aukhalid/evpix_rv32/images/area_comp.png

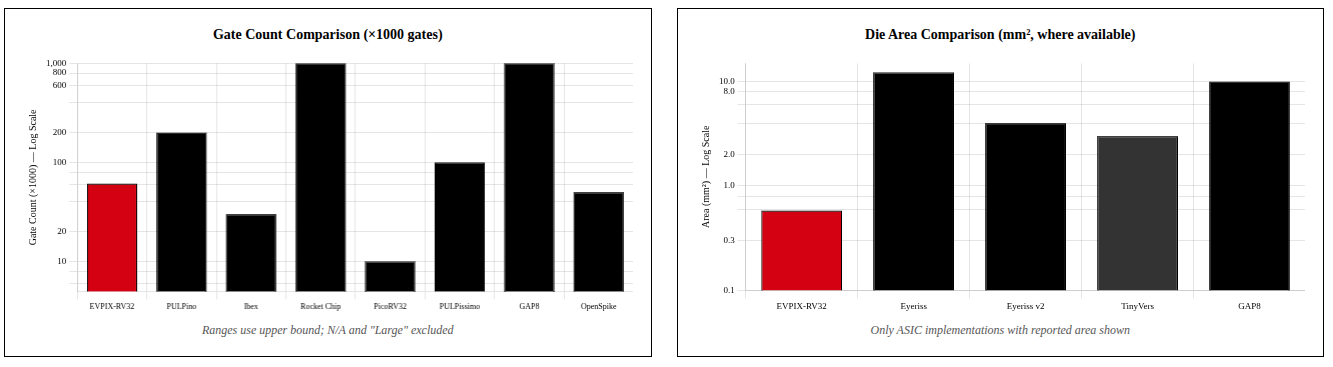
images/area_comp.png
