aukhalid/evpix_rv32/images/asic_heat_map_2_new.png

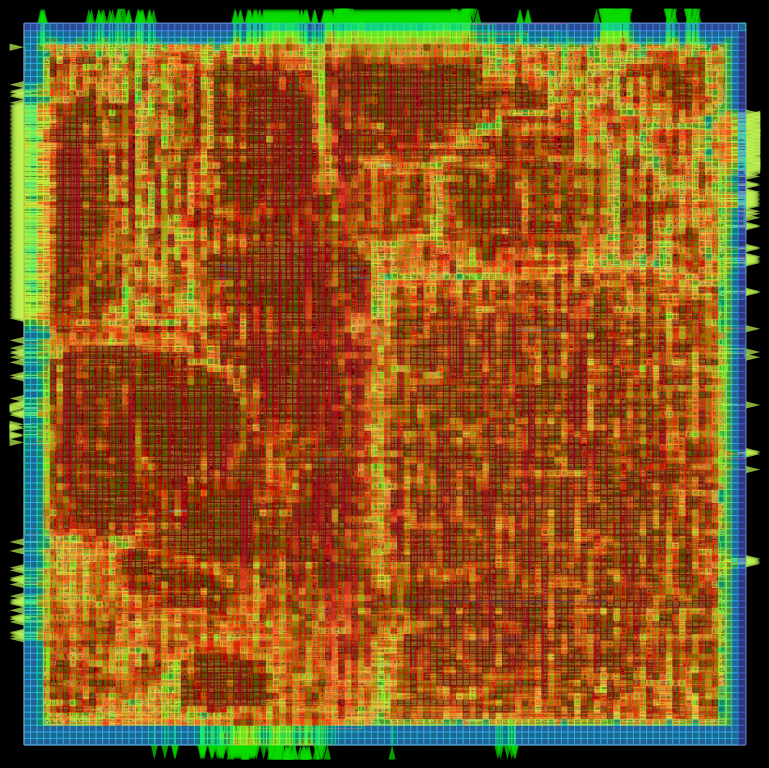
images/asic_heat_map_2_new.png
