aukhalid/evpix_rv32/images/asic_heat_map_new.png

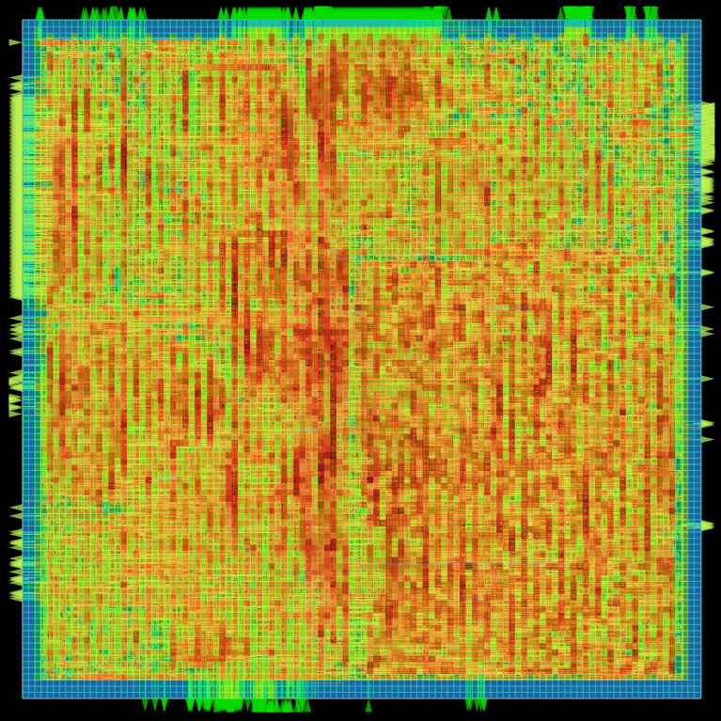
images/asic_heat_map_new.png
