aukhalid/evpix_rv32/images/Basys-3pmod.png

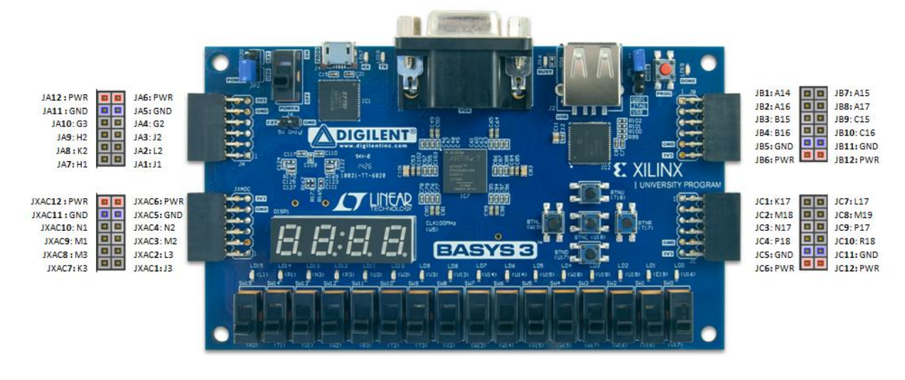
images/Basys-3pmod.png
