aukhalid/evpix_rv32/images/closeup_detailed_asic.png

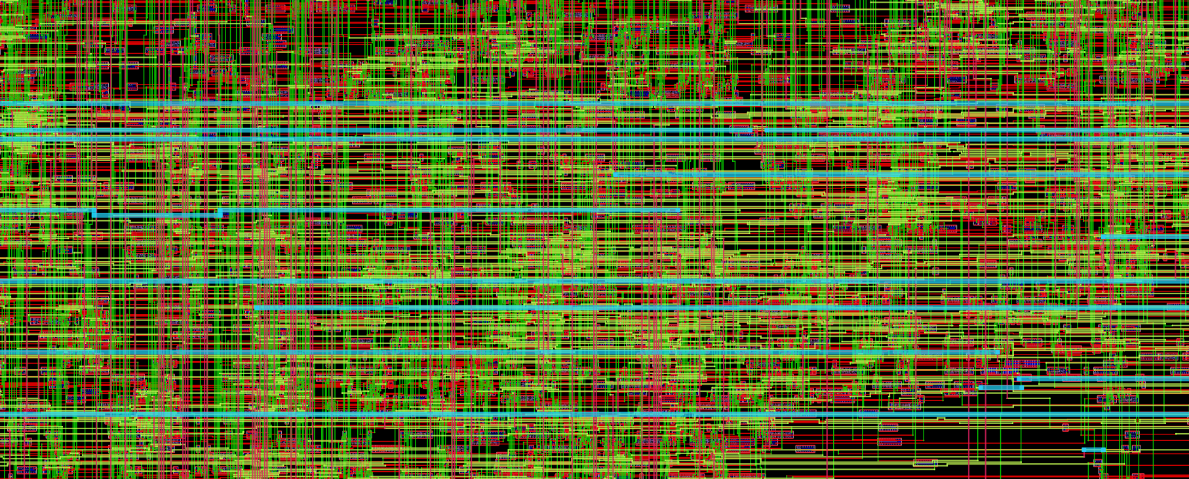
images/closeup_detailed_asic.png
