aukhalid/evpix_rv32/images/custom_ins.png

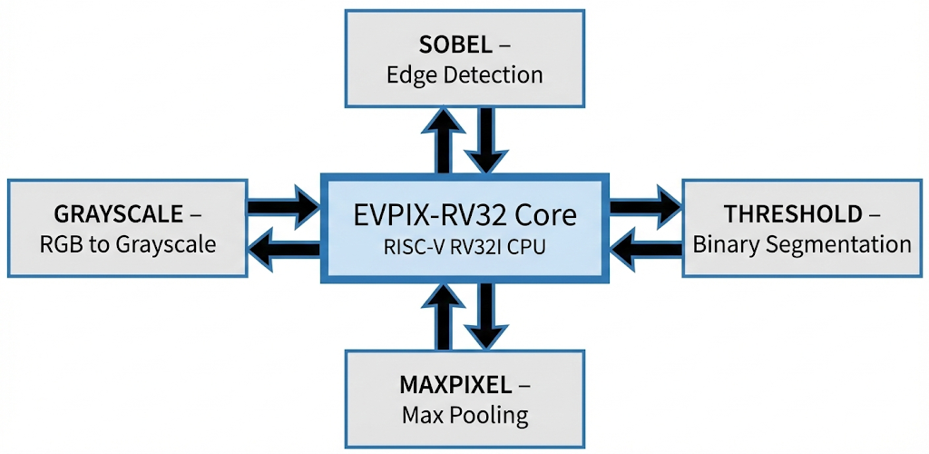
images/custom_ins.png
