aukhalid/evpix_rv32/images/detailed_transistor_layout_alu.png

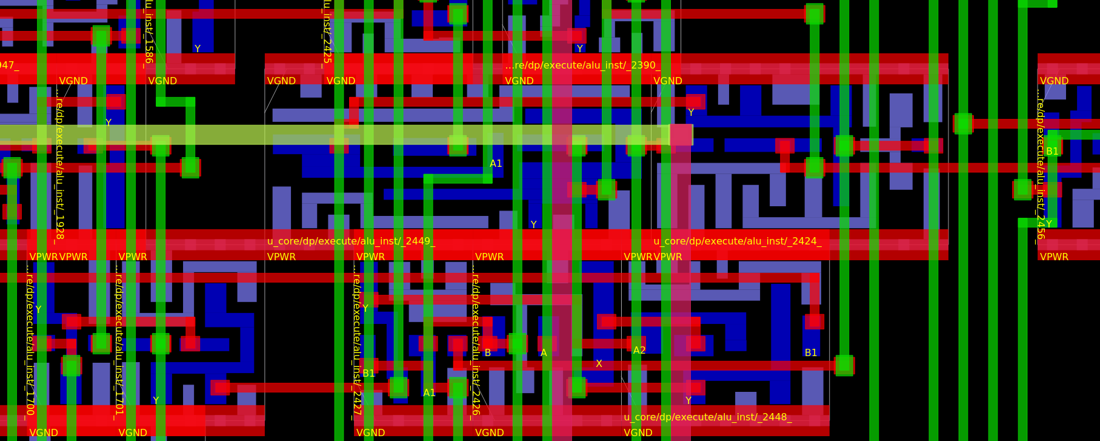
images/detailed_transistor_layout_alu.png
