aukhalid/evpix_rv32/images/evpix_comparison_features2.png

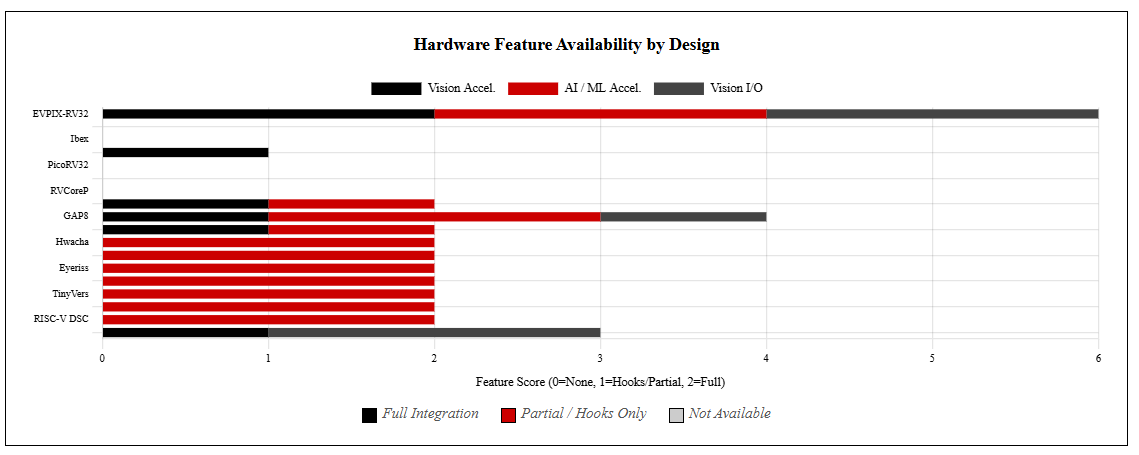
images/evpix_comparison_features2.png
