aukhalid/evpix_rv32/images/evpix_comparison_final_position2.png

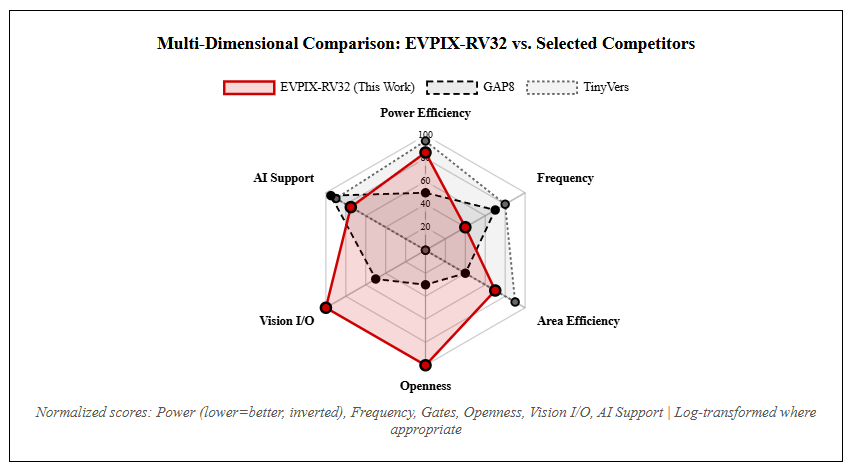
images/evpix_comparison_final_position2.png
