aukhalid/evpix_rv32/images/evpix_comparison_final_position.png

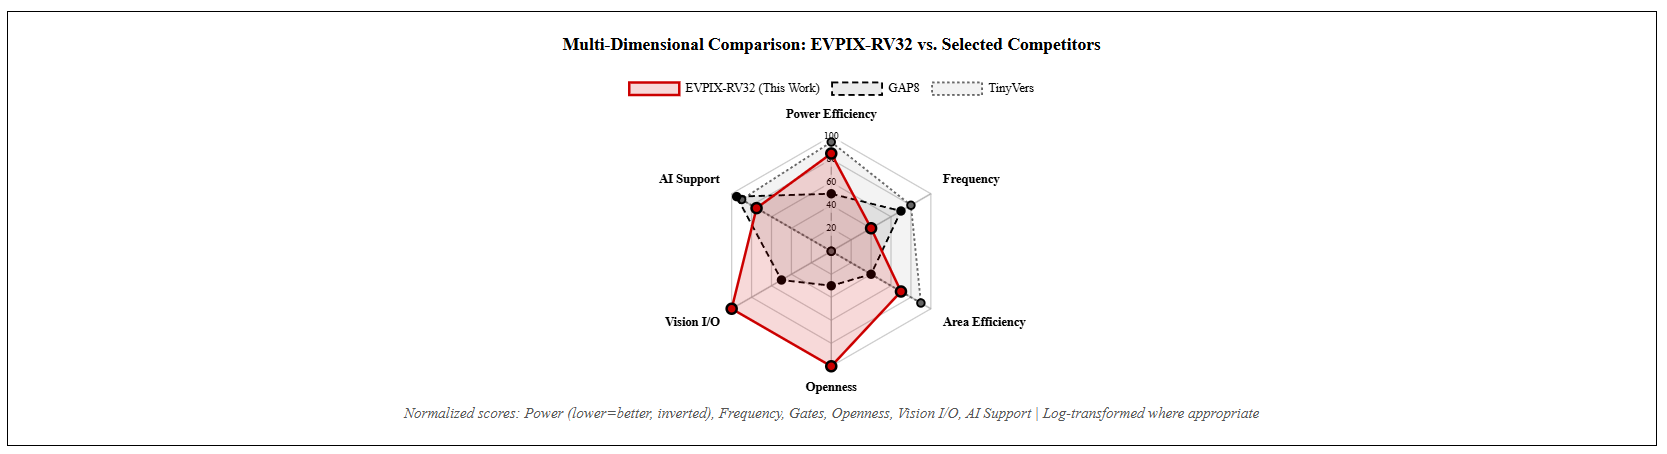
images/evpix_comparison_final_position.png
