aukhalid/evpix_rv32/images/evpix_comparison_open_source.png

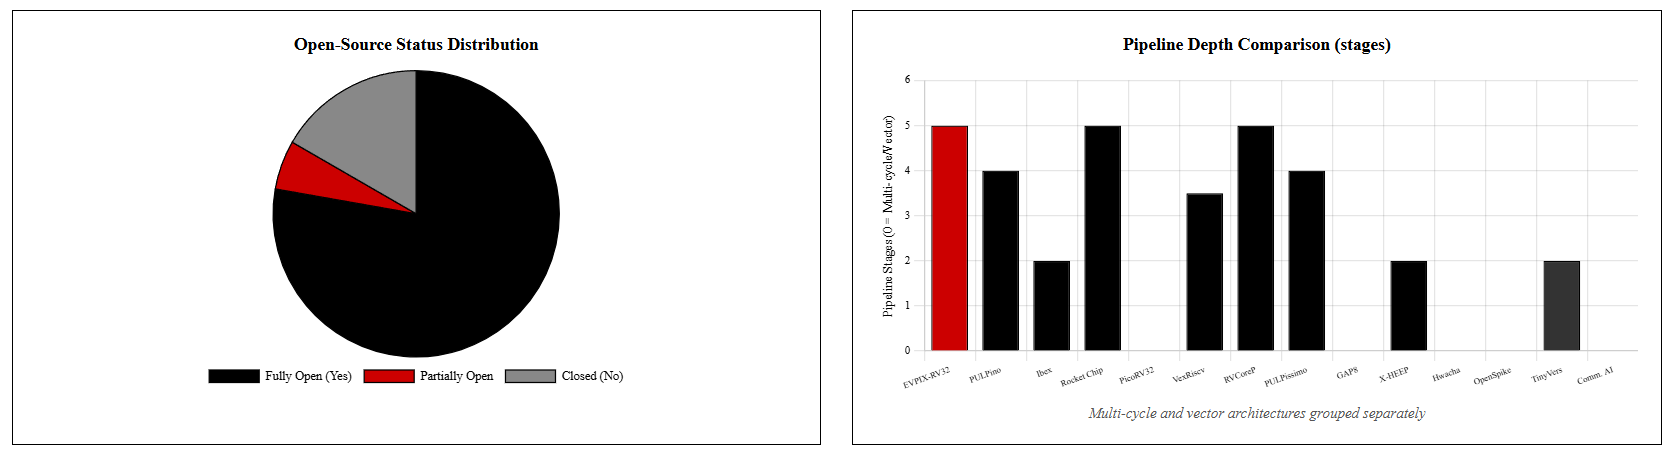
images/evpix_comparison_open_source.png
