aukhalid/evpix_rv32/images/evpix_comparison_power2.png

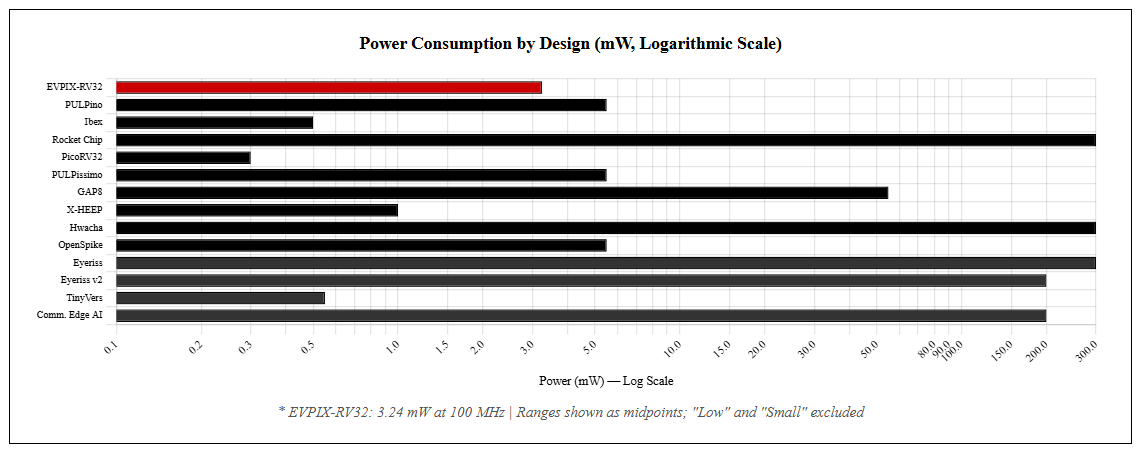
images/evpix_comparison_power2.png
