aukhalid/evpix_rv32/images/evpix_comparison_power.png

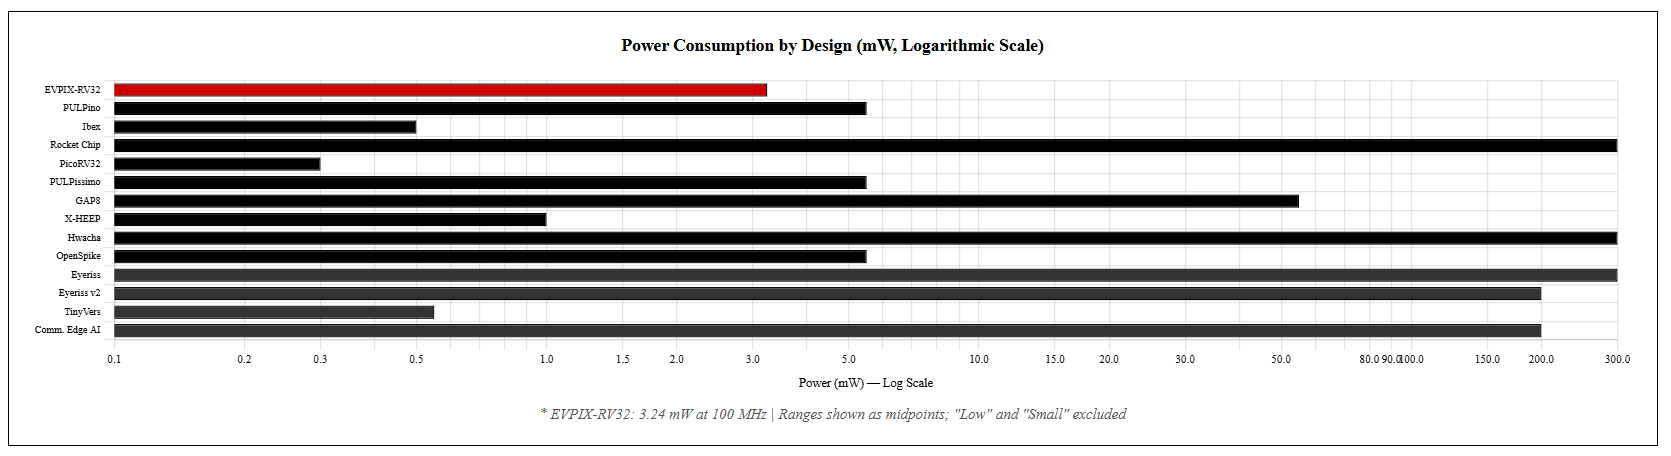
images/evpix_comparison_power.png
