aukhalid/evpix_rv32/images/evpix_comparison_table.png

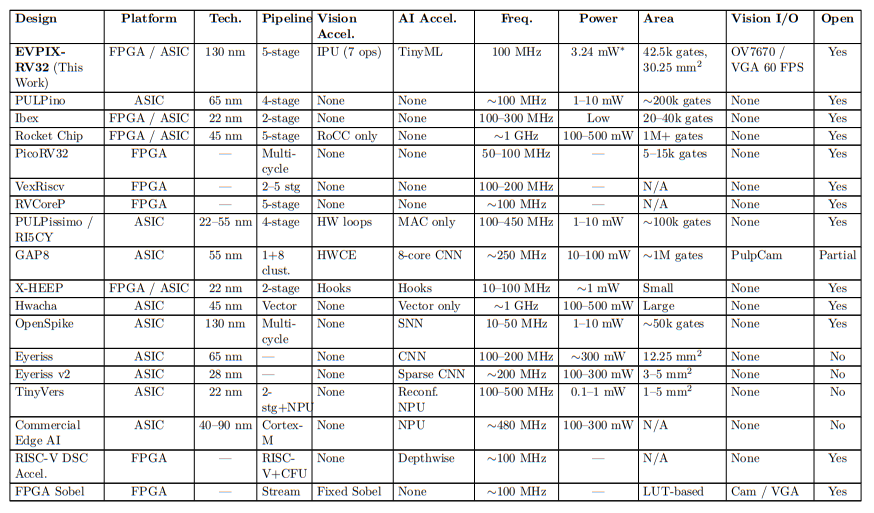
images/evpix_comparison_table.png
