aukhalid/evpix_rv32/images/evpix_comparison_technology.png

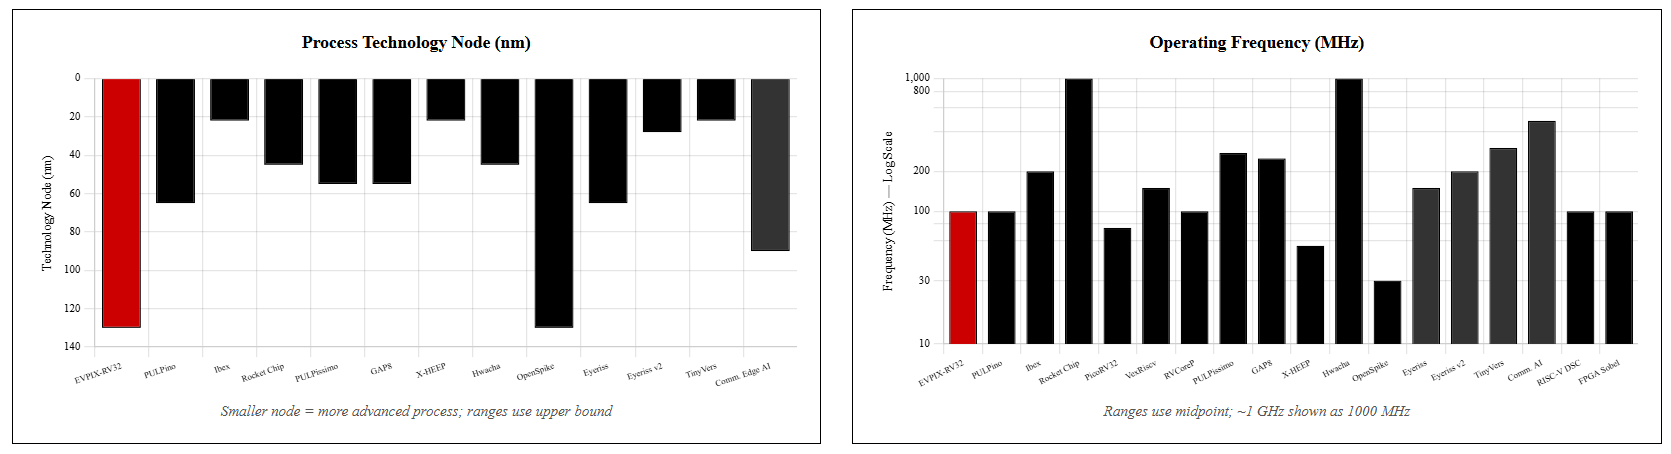
images/evpix_comparison_technology.png
