aukhalid/evpix_rv32/images/feature_comp.png

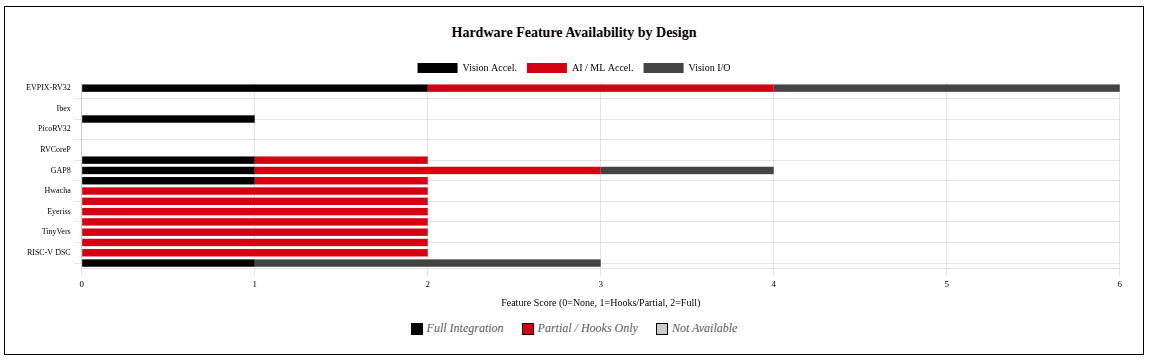
images/feature_comp.png
