aukhalid/evpix_rv32/images/fetch.png

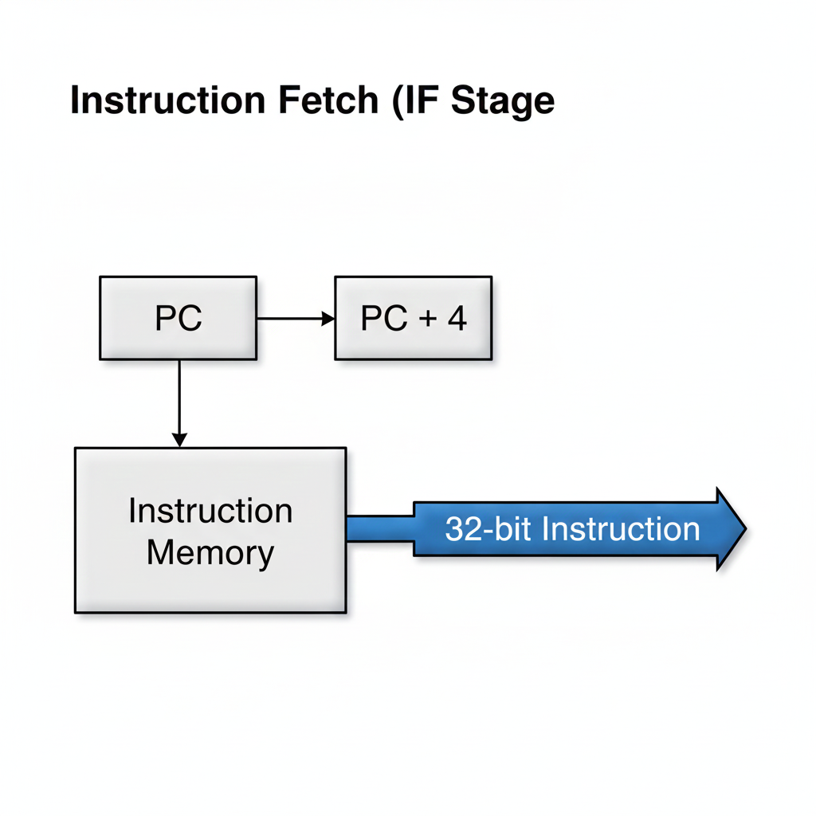
images/fetch.png
