aukhalid/evpix_rv32/images/fpga.png

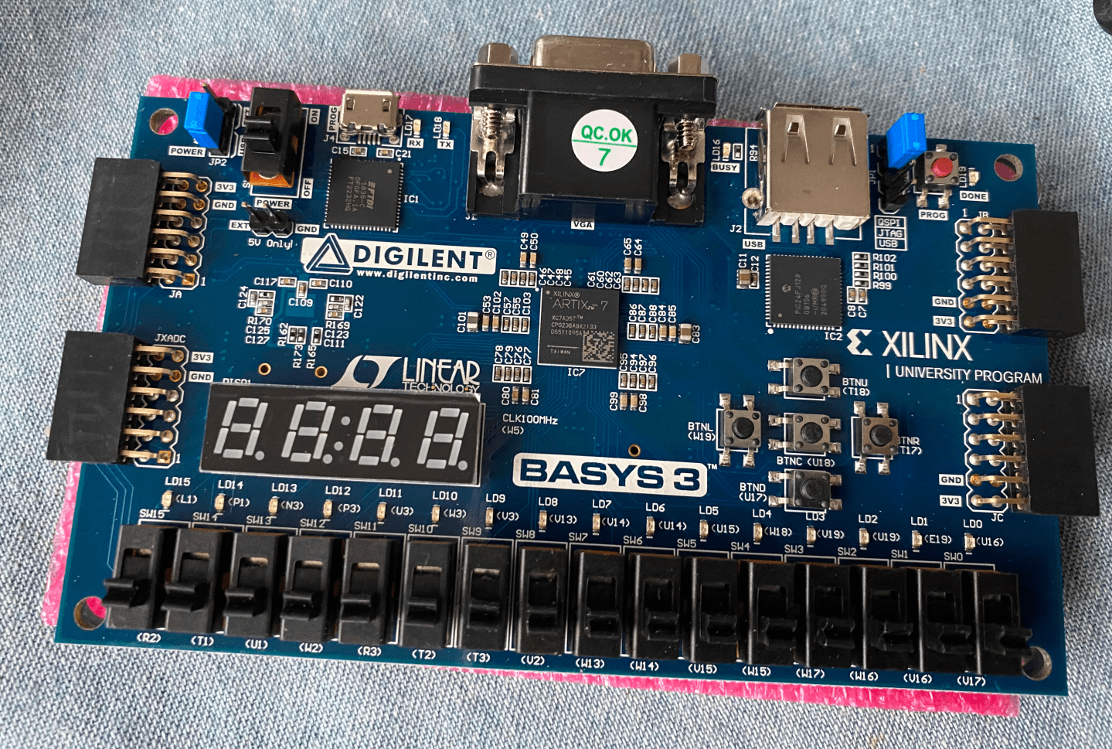
images/fpga.png
