aukhalid/evpix_rv32/images/fpga_power.png

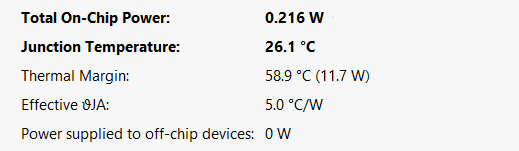
images/fpga_power.png
