aukhalid/evpix_rv32/images/fpga_time.png

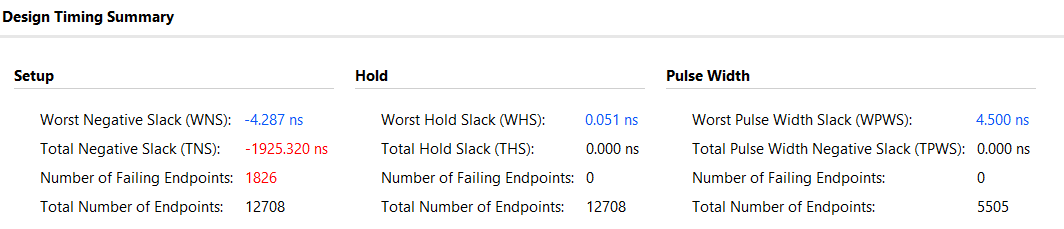
images/fpga_time.png
