aukhalid/evpix_rv32/images/fpga_ut.png

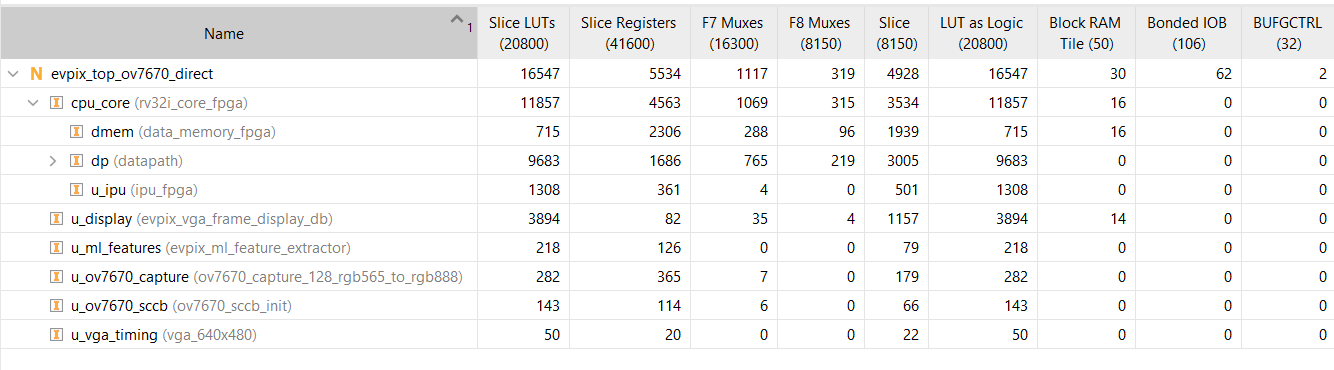
images/fpga_ut.png
