aukhalid/evpix_rv32/images/Harvard-architecture.jpg

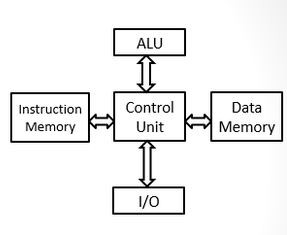
images/Harvard-architecture.jpg
