aukhalid/evpix_rv32/images/hazerd.png

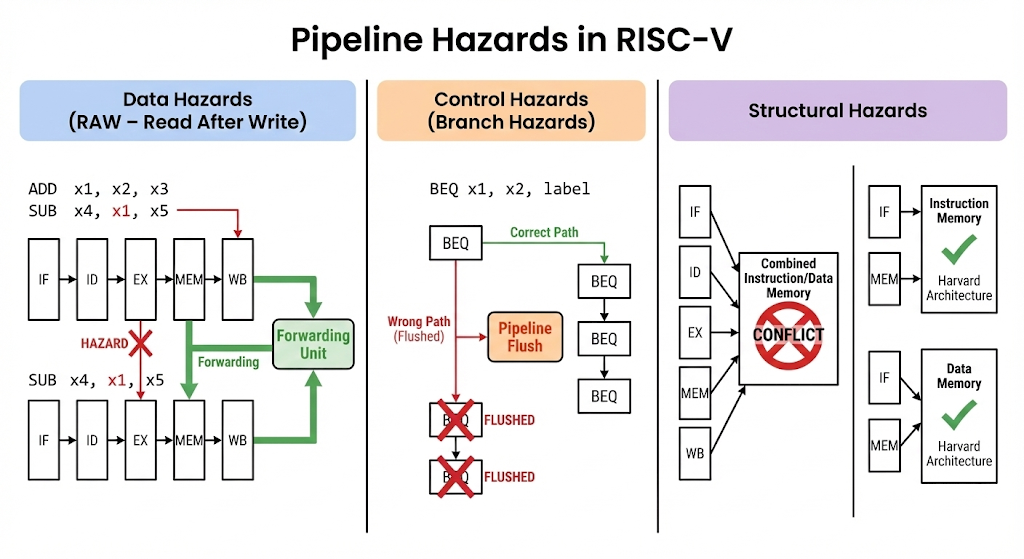
images/hazerd.png
