aukhalid/evpix_rv32/images/io_right.png

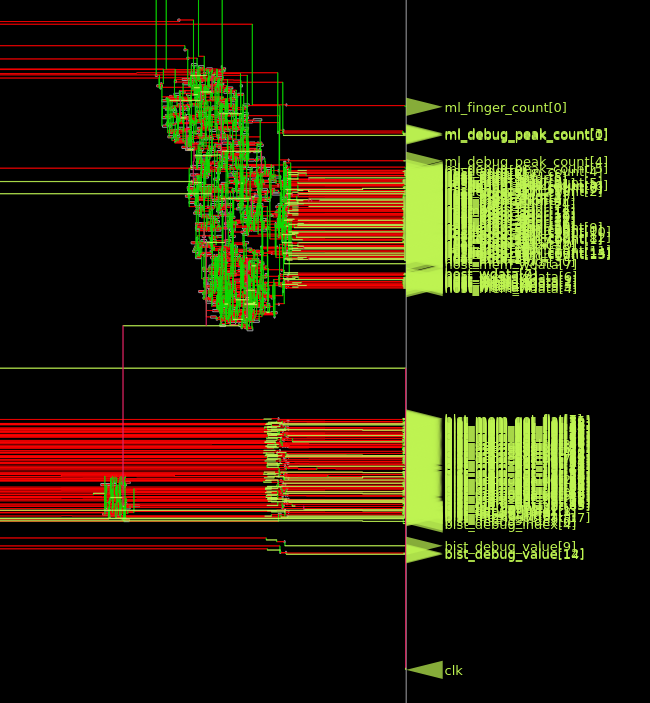
images/io_right.png
