aukhalid/evpix_rv32/images/lut.png

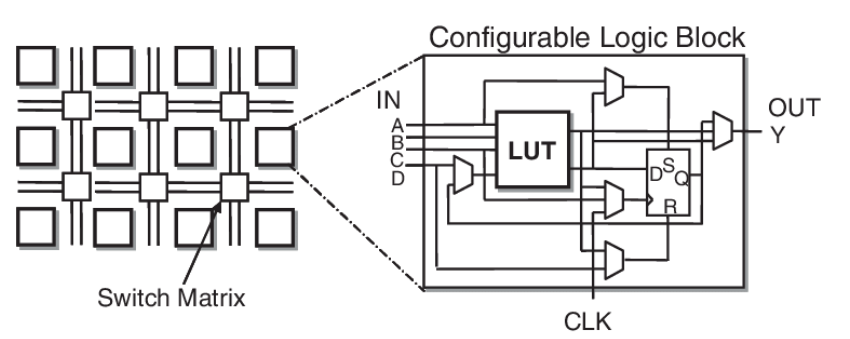
images/lut.png
