aukhalid/evpix_rv32/images/overall_comp.png

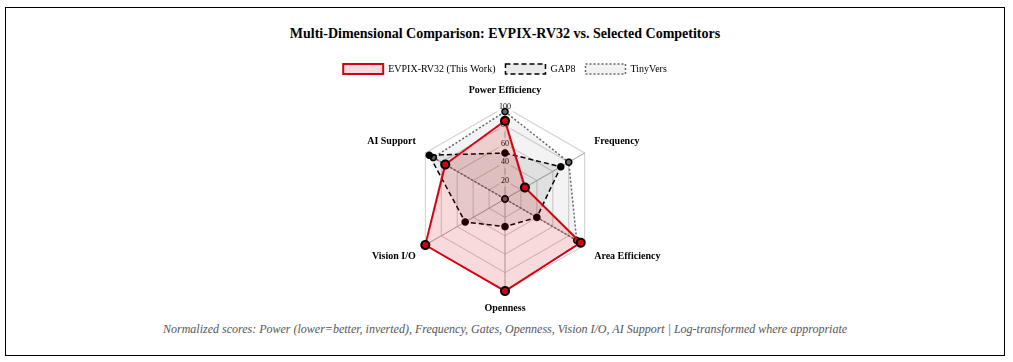
images/overall_comp.png
