aukhalid/evpix_rv32/images/reg_types.png

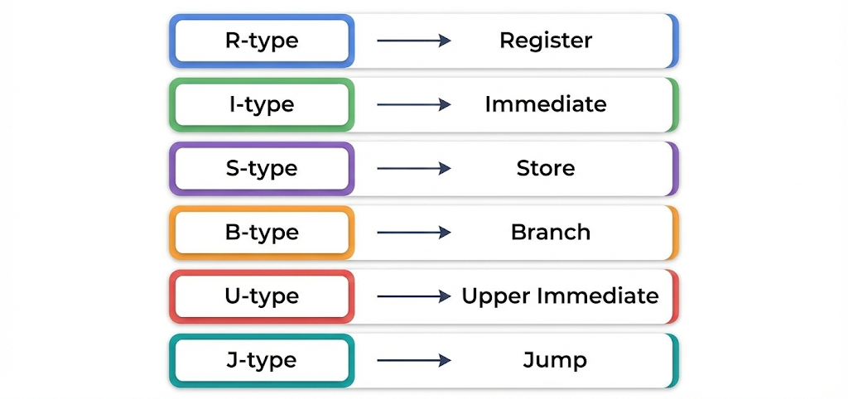
images/reg_types.png
