aukhalid/evpix_rv32/images/soc_top_detailed.png

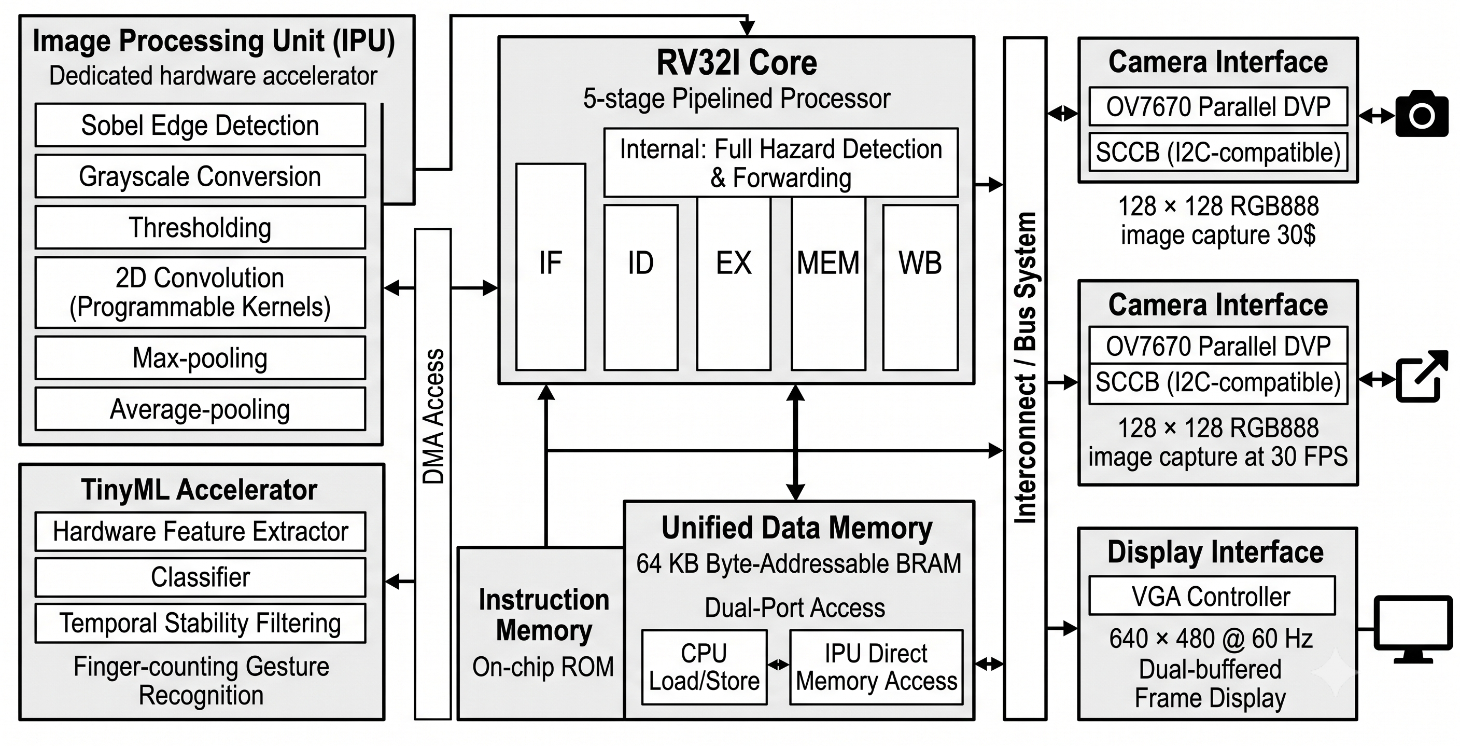
images/soc_top_detailed.png
