aukhalid/evpix_rv32/images/spi_input_13fps.png

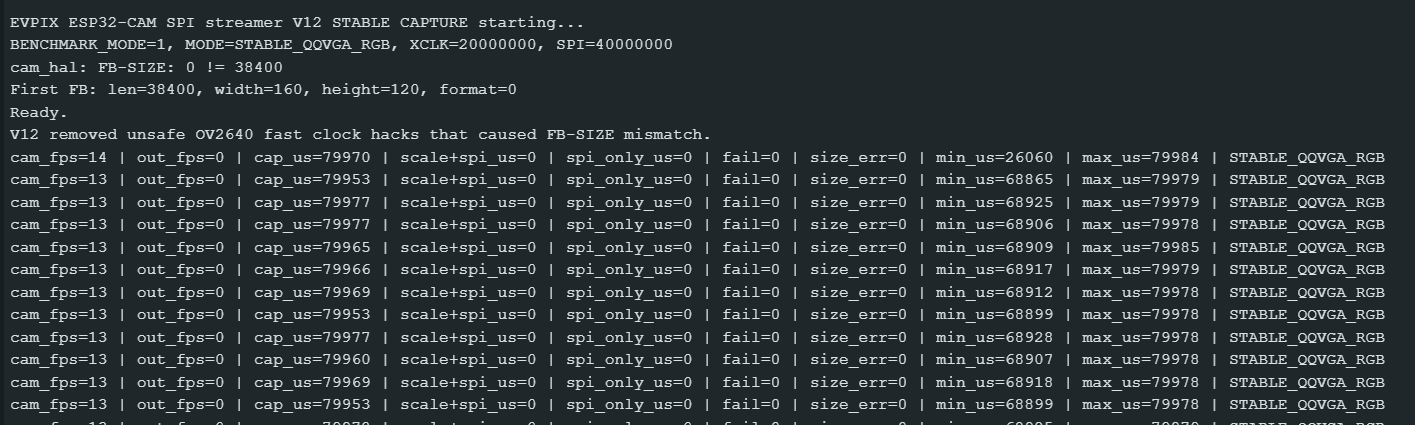
images/spi_input_13fps.png
