aukhalid/evpix_rv32/images/spi_output_133fps.png

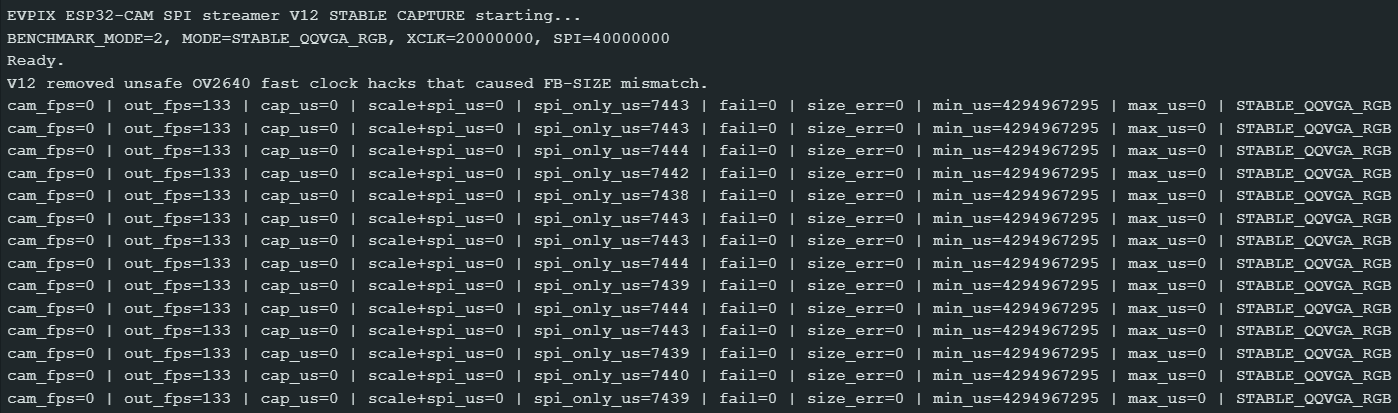
images/spi_output_133fps.png
