aukhalid/evpix_rv32/images/webcam_fps.png

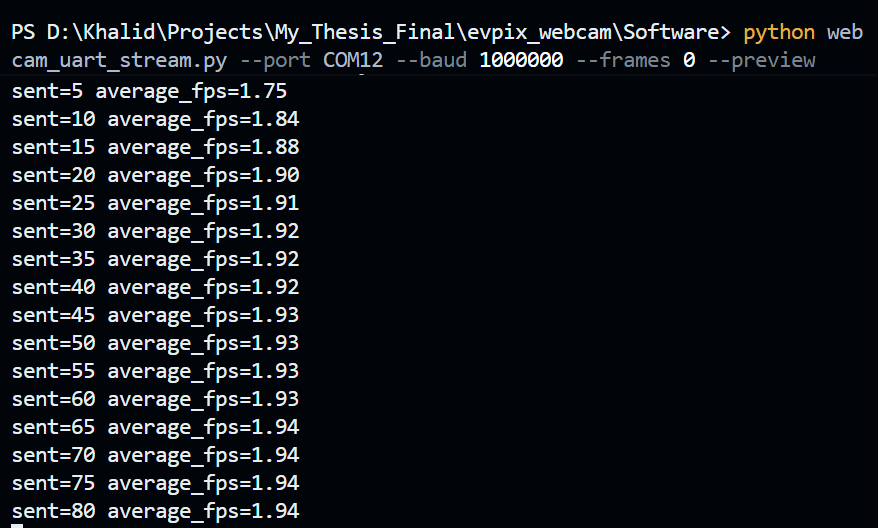
images/webcam_fps.png
