aukhalid/evpix_rv32/images/asic_all_results_summary.png

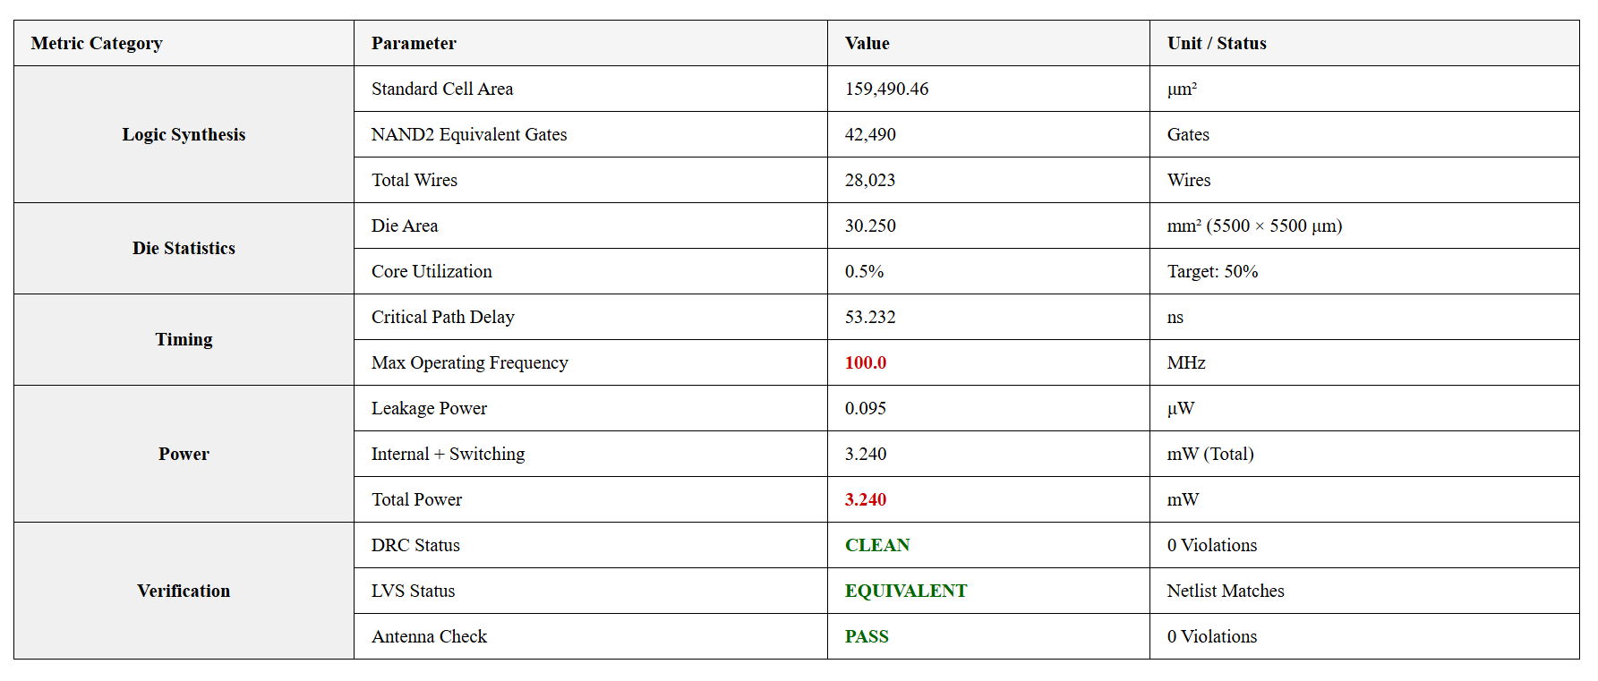
images/asic_all_results_summary.png
