aukhalid/evpix_rv32/images/asic_power_results2.png

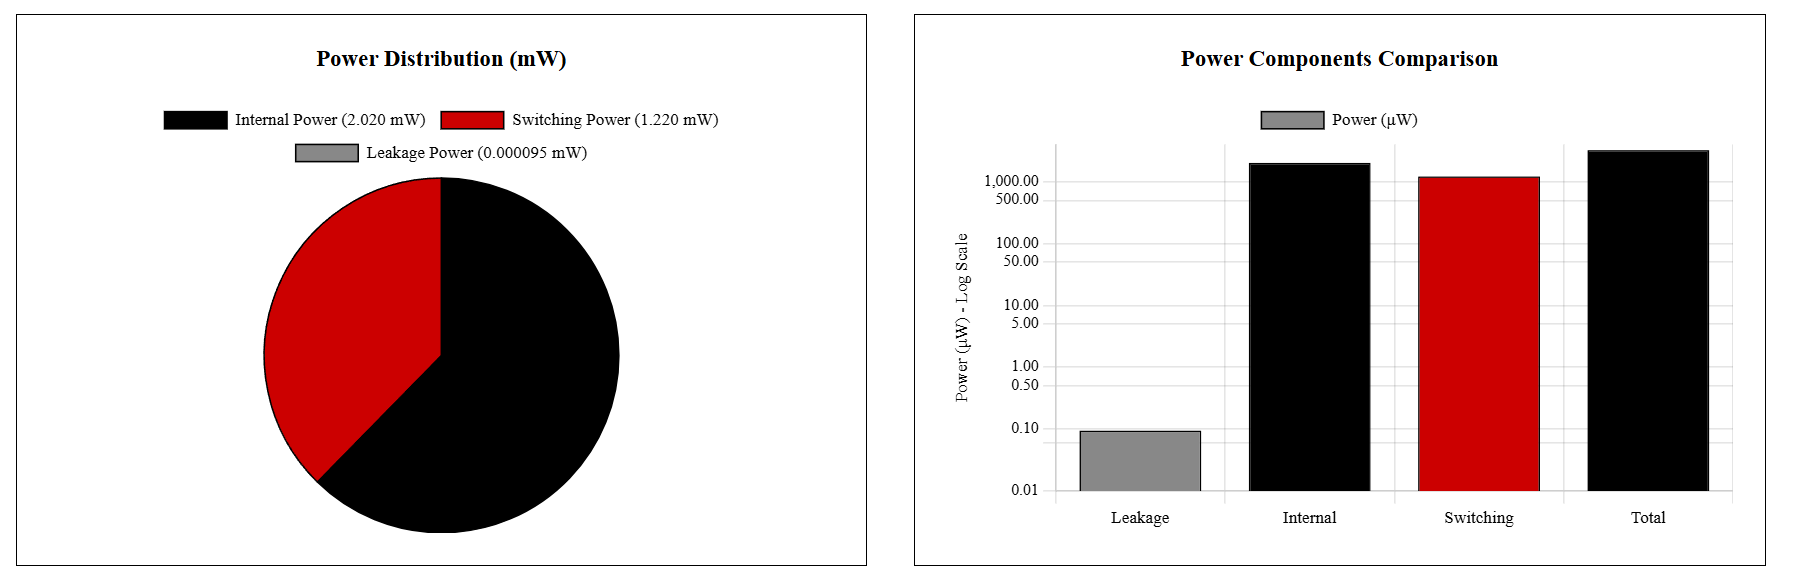
images/asic_power_results2.png
