aukhalid/evpix_rv32/images/asic_power_summary_results.png

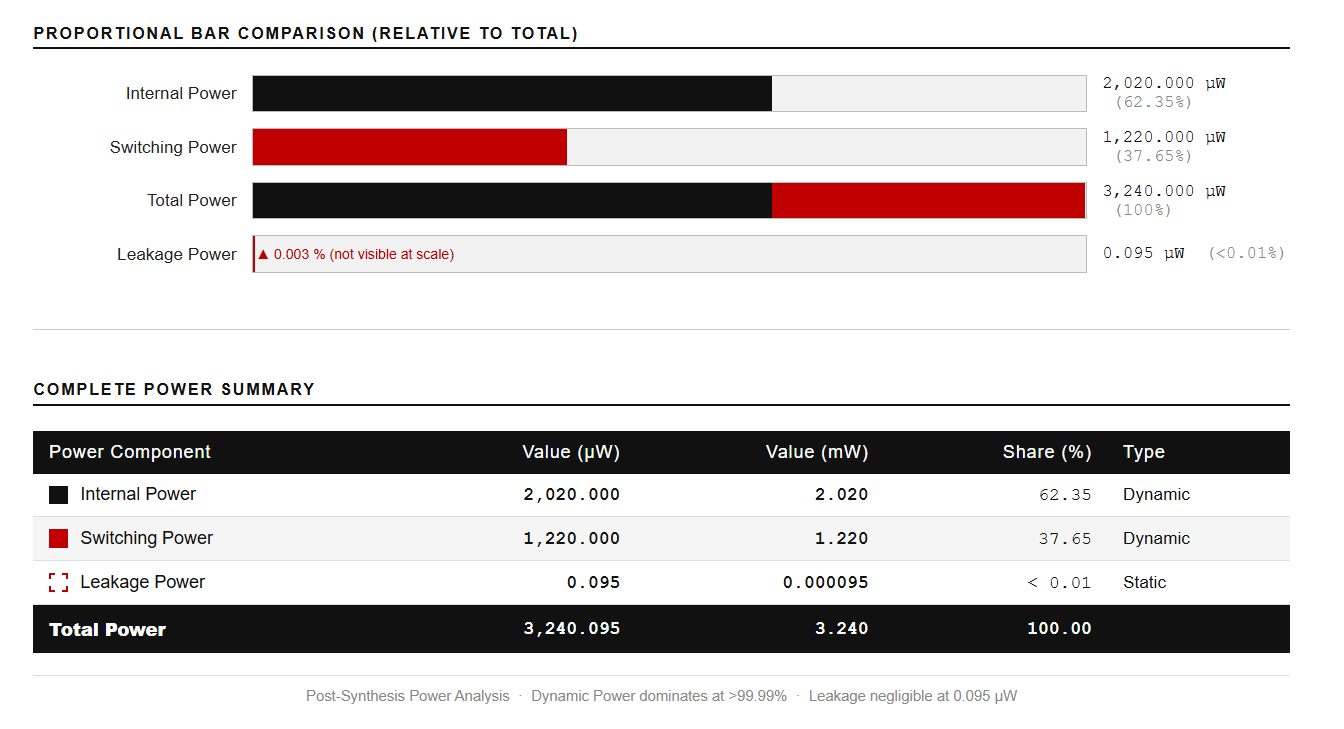
images/asic_power_summary_results.png
