aukhalid/evpix_rv32/images/asic_timing_results2.png

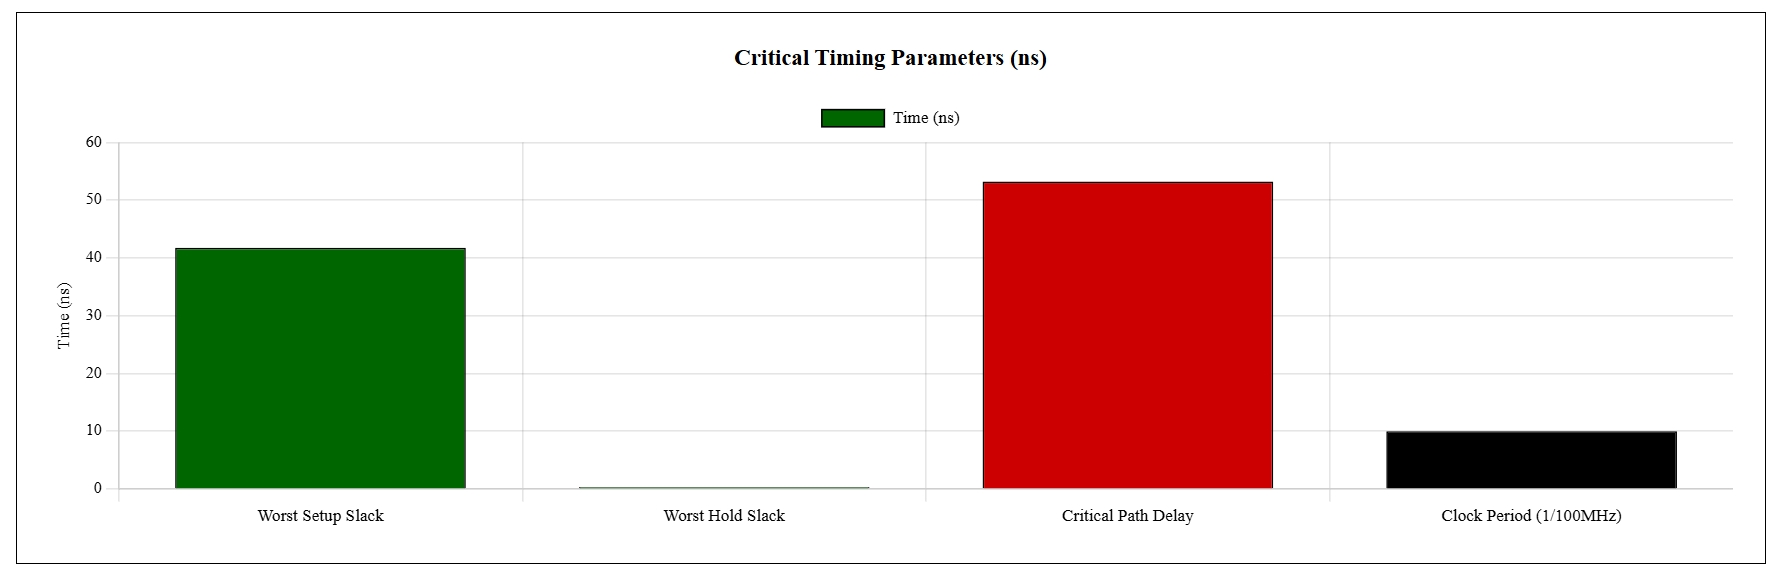
images/asic_timing_results2.png
