aukhalid/evpix_rv32/images/asic_timing_results.png

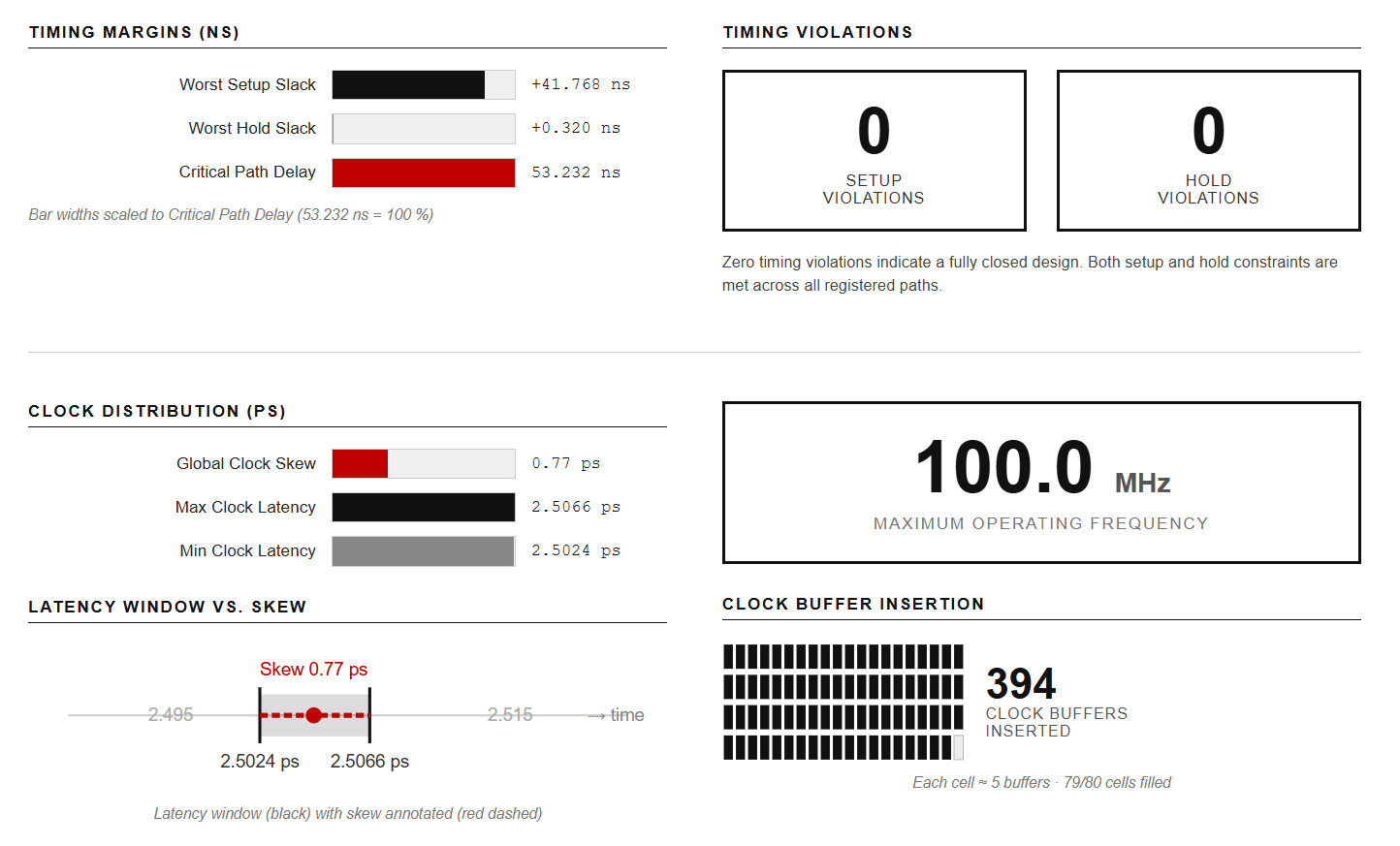
images/asic_timing_results.png
