aukhalid/evpix_rv32/images/asic_timing_results_summary.png

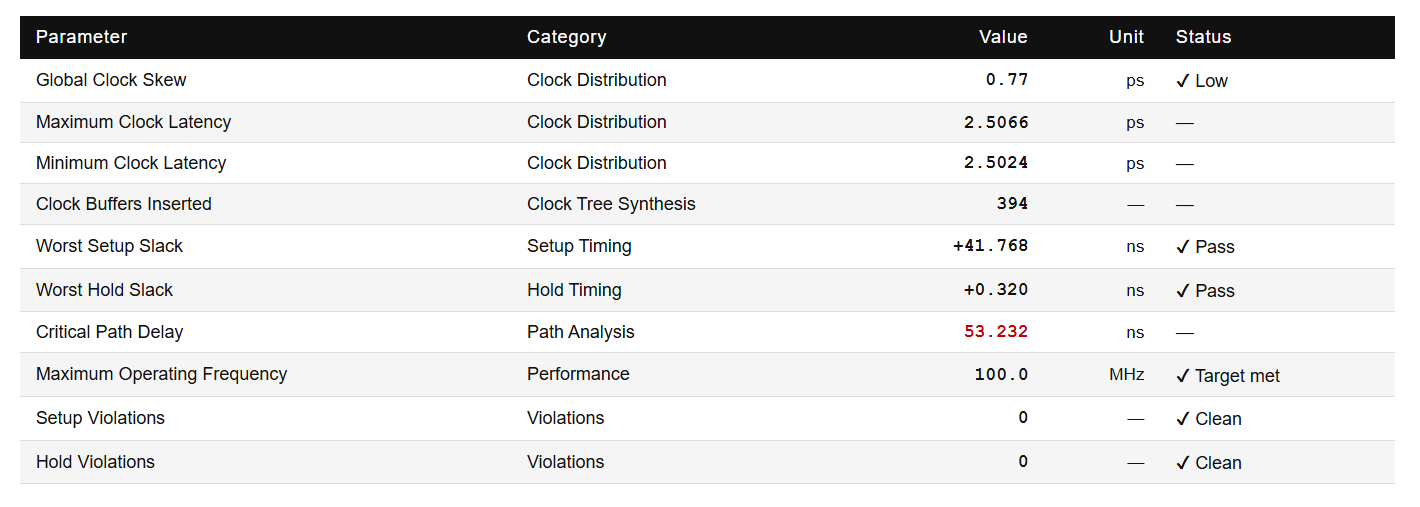
images/asic_timing_results_summary.png
