aukhalid/evpix_rv32/images/asic_verification.png

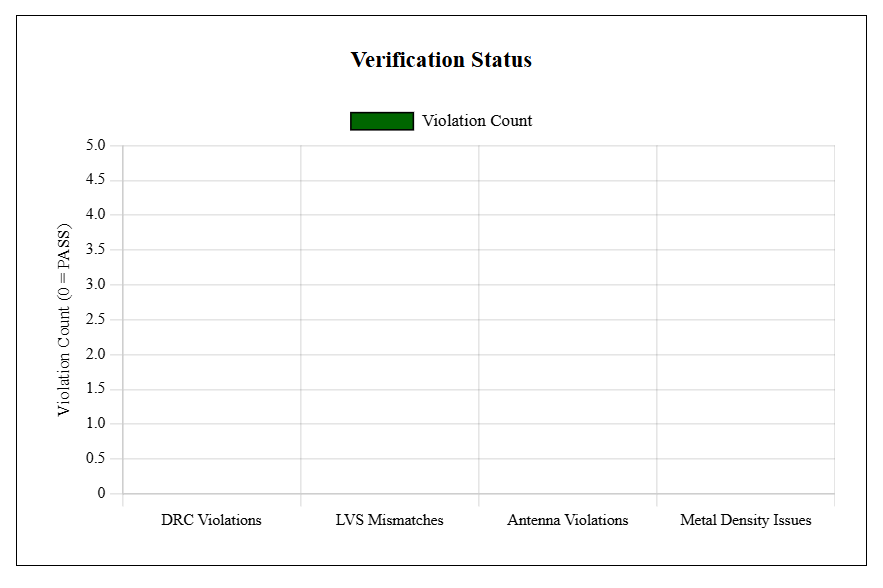
images/asic_verification.png
