aukhalid/evpix_rv32/images/floorplan_results.png

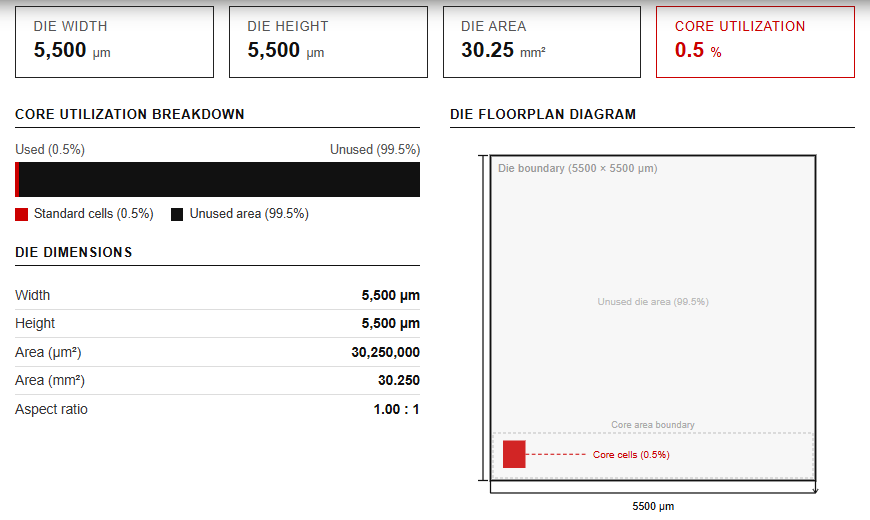
images/floorplan_results.png
