aukhalid/evpix_rv32/images/synthesis_all_results.png

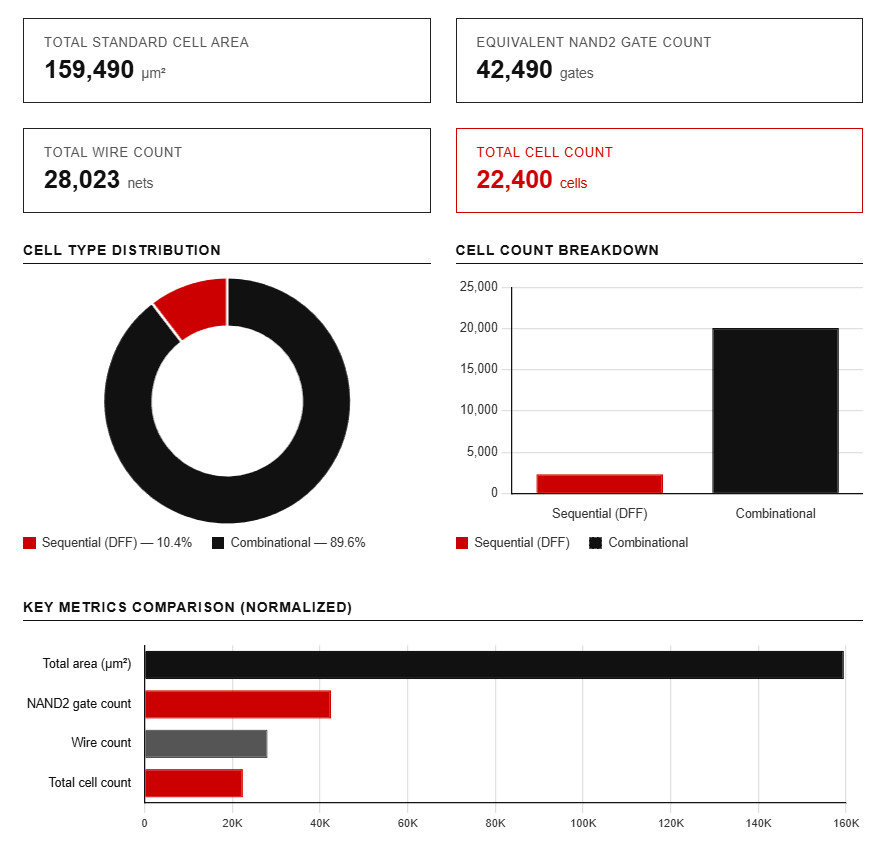
images/synthesis_all_results.png
