aukhalid/evpix_rv32/images/synthesis_results2.png

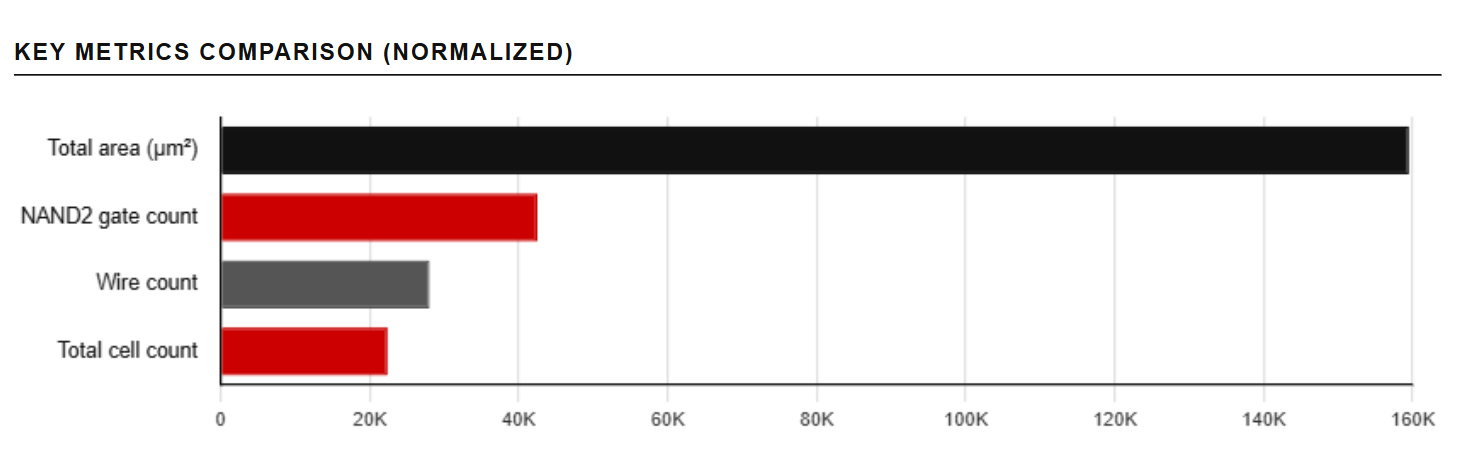
images/synthesis_results2.png
