aukhalid/evpix_rv32/images/synthesis_results3.png

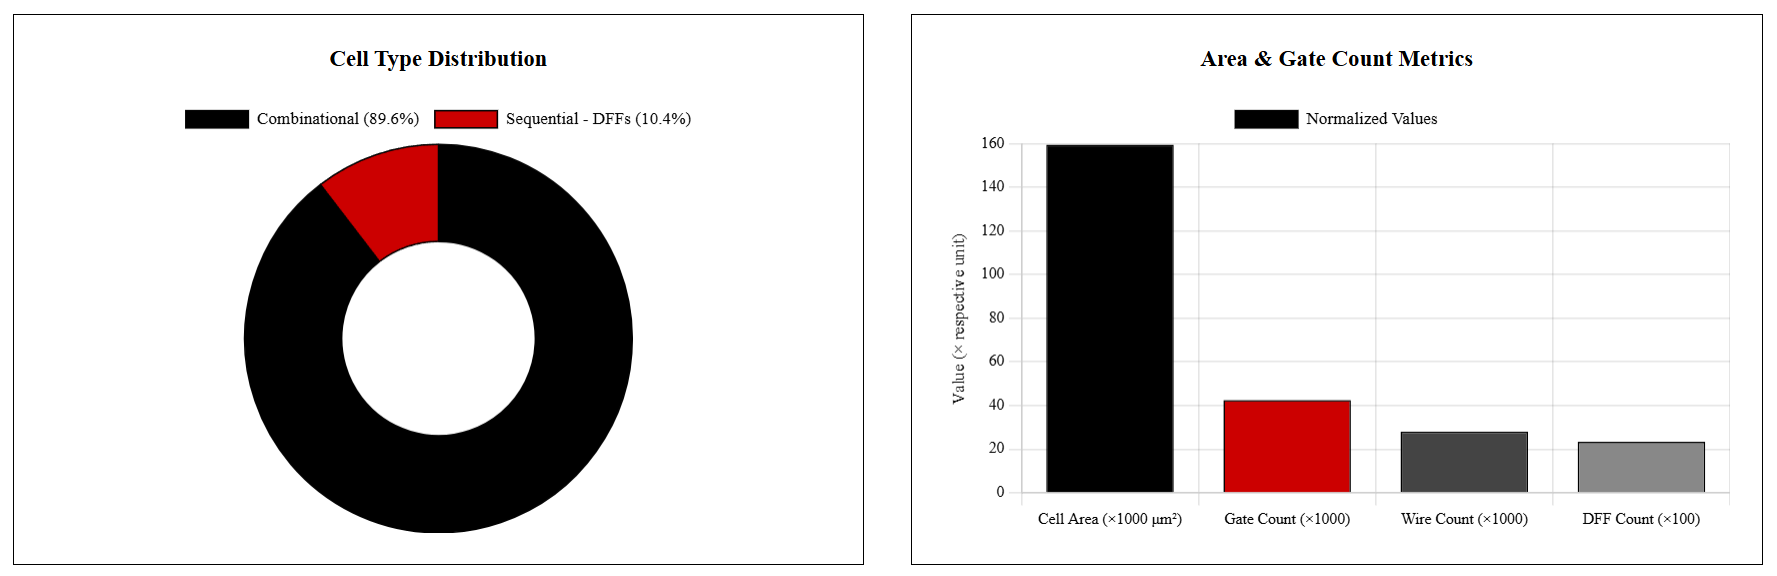
images/synthesis_results3.png
