aukhalid/evpix_rv32/images/synthesis_results.png

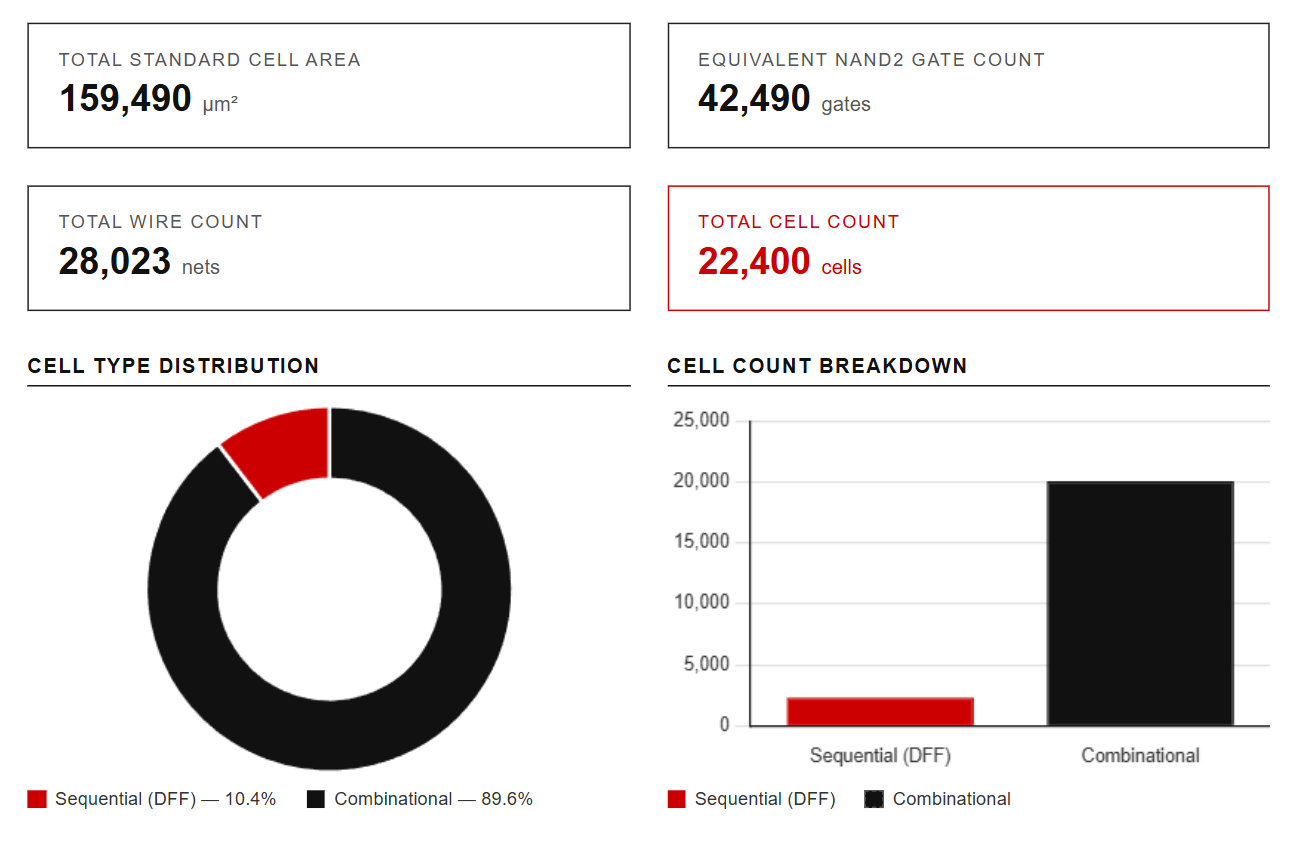
images/synthesis_results.png
