aukhalid/evpix_rv32/fpga/constrains/evpix_basys3.xdc

## evpix_ov7670_direct_basys3_pmod_ja_jb.xdc
## Basys 3 + OV7670 direct parallel camera input for EVPIX-RV32.
## Set top module: evpix_top_ov7670_direct

## Clock and reset
set_property PACKAGE_PIN W5 [get_ports clk_100mhz]
set_property IOSTANDARD LVCMOS33 [get_ports clk_100mhz]
create_clock -add -name sys_clk_pin -period 10.000 -waveform {0 5} [get_ports clk_100mhz]

set_property PACKAGE_PIN U18 [get_ports reset_btn]
set_property IOSTANDARD LVCMOS33 [get_ports reset_btn]


## OV7670 data bus on PMOD JA
## Camera D0..D7 -> Basys 3 JA1,JA2,JA3,JA4,JA7,JA8,JA9,JA10
set_property PACKAGE_PIN J1 [get_ports {ov7670_d[0]}]
set_property IOSTANDARD LVCMOS33 [get_ports {ov7670_d[0]}]
set_property PACKAGE_PIN L2 [get_ports {ov7670_d[1]}]
set_property IOSTANDARD LVCMOS33 [get_ports {ov7670_d[1]}]
set_property PACKAGE_PIN J2 [get_ports {ov7670_d[2]}]
set_property IOSTANDARD LVCMOS33 [get_ports {ov7670_d[2]}]
set_property PACKAGE_PIN G2 [get_ports {ov7670_d[3]}]
set_property IOSTANDARD LVCMOS33 [get_ports {ov7670_d[3]}]
set_property PACKAGE_PIN H1 [get_ports {ov7670_d[4]}]
set_property IOSTANDARD LVCMOS33 [get_ports {ov7670_d[4]}]
set_property PACKAGE_PIN K2 [get_ports {ov7670_d[5]}]
set_property IOSTANDARD LVCMOS33 [get_ports {ov7670_d[5]}]
set_property PACKAGE_PIN H2 [get_ports {ov7670_d[6]}]
set_property IOSTANDARD LVCMOS33 [get_ports {ov7670_d[6]}]
set_property PACKAGE_PIN G3 [get_ports {ov7670_d[7]}]
set_property IOSTANDARD LVCMOS33 [get_ports {ov7670_d[7]}]

## OV7670 clocks/sync/control on PMOD JB
## PCLK=JB1, HREF=JB2, VSYNC=JB3, XCLK=JB4, SIOC=JB7, SIOD=JB8, PWDN=JB9, RESET_N=JB10
set_property PACKAGE_PIN A14 [get_ports ov7670_pclk]
set_property IOSTANDARD LVCMOS33 [get_ports ov7670_pclk]
set_property PACKAGE_PIN A16 [get_ports ov7670_href]
set_property IOSTANDARD LVCMOS33 [get_ports ov7670_href]
set_property PACKAGE_PIN B15 [get_ports ov7670_vsync]
set_property IOSTANDARD LVCMOS33 [get_ports ov7670_vsync]
set_property PACKAGE_PIN B16 [get_ports ov7670_xclk]
set_property IOSTANDARD LVCMOS33 [get_ports ov7670_xclk]
set_property DRIVE 8 [get_ports ov7670_xclk]
set_property SLEW FAST [get_ports ov7670_xclk]
set_property PACKAGE_PIN A15 [get_ports ov7670_sioc]
set_property IOSTANDARD LVCMOS33 [get_ports ov7670_sioc]
set_property PACKAGE_PIN A17 [get_ports ov7670_siod]
set_property IOSTANDARD LVCMOS33 [get_ports ov7670_siod]
set_property PULLUP true [get_ports ov7670_siod]
set_property PACKAGE_PIN C15 [get_ports ov7670_pwdn]
set_property IOSTANDARD LVCMOS33 [get_ports ov7670_pwdn]
set_property PACKAGE_PIN C16 [get_ports ov7670_reset_n]
set_property IOSTANDARD LVCMOS33 [get_ports ov7670_reset_n]

## Camera pins are asynchronous to clk_100mhz; capture module synchronizes them.
set_false_path -from [get_ports ov7670_pclk]
set_false_path -from [get_ports ov7670_href]
set_false_path -from [get_ports ov7670_vsync]
set_false_path -from [get_ports {ov7670_d[*]}]

## LEDs

set_property PACKAGE_PIN U16 [get_ports {led[0]}]
set_property IOSTANDARD LVCMOS33 [get_ports {led[0]}]
set_property PACKAGE_PIN E19 [get_ports {led[1]}]
set_property IOSTANDARD LVCMOS33 [get_ports {led[1]}]
set_property PACKAGE_PIN U19 [get_ports {led[2]}]
set_property IOSTANDARD LVCMOS33 [get_ports {led[2]}]
set_property PACKAGE_PIN V19 [get_ports {led[3]}]
set_property IOSTANDARD LVCMOS33 [get_ports {led[3]}]
set_property PACKAGE_PIN W18 [get_ports {led[4]}]
set_property IOSTANDARD LVCMOS33 [get_ports {led[4]}]
set_property PACKAGE_PIN U15 [get_ports {led[5]}]
set_property IOSTANDARD LVCMOS33 [get_ports {led[5]}]
set_property PACKAGE_PIN U14 [get_ports {led[6]}]
set_property IOSTANDARD LVCMOS33 [get_ports {led[6]}]
set_property PACKAGE_PIN V14 [get_ports {led[7]}]
set_property IOSTANDARD LVCMOS33 [get_ports {led[7]}]
set_property PACKAGE_PIN V13 [get_ports {led[8]}]
set_property IOSTANDARD LVCMOS33 [get_ports {led[8]}]
set_property PACKAGE_PIN V3 [get_ports {led[9]}]
set_property IOSTANDARD LVCMOS33 [get_ports {led[9]}]
set_property PACKAGE_PIN W3 [get_ports {led[10]}]
set_property IOSTANDARD LVCMOS33 [get_ports {led[10]}]
set_property PACKAGE_PIN U3 [get_ports {led[11]}]
set_property IOSTANDARD LVCMOS33 [get_ports {led[11]}]
set_property PACKAGE_PIN P3 [get_ports {led[12]}]
set_property IOSTANDARD LVCMOS33 [get_ports {led[12]}]
set_property PACKAGE_PIN N3 [get_ports {led[13]}]
set_property IOSTANDARD LVCMOS33 [get_ports {led[13]}]
set_property PACKAGE_PIN P1 [get_ports {led[14]}]
set_property IOSTANDARD LVCMOS33 [get_ports {led[14]}]
set_property PACKAGE_PIN L1 [get_ports {led[15]}]
set_property IOSTANDARD LVCMOS33 [get_ports {led[15]}]

## VGA
set_property PACKAGE_PIN G19 [get_ports {vga_r[0]}]
set_property IOSTANDARD LVCMOS33 [get_ports {vga_r[0]}]
set_property PACKAGE_PIN H19 [get_ports {vga_r[1]}]
set_property IOSTANDARD LVCMOS33 [get_ports {vga_r[1]}]
set_property PACKAGE_PIN J19 [get_ports {vga_r[2]}]
set_property IOSTANDARD LVCMOS33 [get_ports {vga_r[2]}]
set_property PACKAGE_PIN N19 [get_ports {vga_r[3]}]
set_property IOSTANDARD LVCMOS33 [get_ports {vga_r[3]}]

set_property PACKAGE_PIN J17 [get_ports {vga_g[0]}]
set_property IOSTANDARD LVCMOS33 [get_ports {vga_g[0]}]
set_property PACKAGE_PIN H17 [get_ports {vga_g[1]}]
set_property IOSTANDARD LVCMOS33 [get_ports {vga_g[1]}]
set_property PACKAGE_PIN G17 [get_ports {vga_g[2]}]
set_property IOSTANDARD LVCMOS33 [get_ports {vga_g[2]}]
set_property PACKAGE_PIN D17 [get_ports {vga_g[3]}]
set_property IOSTANDARD LVCMOS33 [get_ports {vga_g[3]}]

set_property PACKAGE_PIN N18 [get_ports {vga_b[0]}]
set_property IOSTANDARD LVCMOS33 [get_ports {vga_b[0]}]
set_property PACKAGE_PIN L18 [get_ports {vga_b[1]}]
set_property IOSTANDARD LVCMOS33 [get_ports {vga_b[1]}]
set_property PACKAGE_PIN K18 [get_ports {vga_b[2]}]
set_property IOSTANDARD LVCMOS33 [get_ports {vga_b[2]}]
set_property PACKAGE_PIN J18 [get_ports {vga_b[3]}]
set_property IOSTANDARD LVCMOS33 [get_ports {vga_b[3]}]

set_property PACKAGE_PIN P19 [get_ports hsync]
set_property IOSTANDARD LVCMOS33 [get_ports hsync]
set_property PACKAGE_PIN R19 [get_ports vsync]
set_property IOSTANDARD LVCMOS33 [get_ports vsync]


## Basys 3 switches for V5 runtime mode/instruction selection
## SW0 = 0 CPU-BIST mode, 1 IPU mode
## SW1 = SOBEL, SW2 = GRAY, SW3 = THRESH, SW4 = CONV_IDENTITY
set_property PACKAGE_PIN V17 [get_ports {sw[0]}]
set_property IOSTANDARD LVCMOS33 [get_ports {sw[0]}]
set_property PACKAGE_PIN V16 [get_ports {sw[1]}]
set_property IOSTANDARD LVCMOS33 [get_ports {sw[1]}]
set_property PACKAGE_PIN W16 [get_ports {sw[2]}]
set_property IOSTANDARD LVCMOS33 [get_ports {sw[2]}]
set_property PACKAGE_PIN W17 [get_ports {sw[3]}]
set_property IOSTANDARD LVCMOS33 [get_ports {sw[3]}]
set_property PACKAGE_PIN W15 [get_ports {sw[4]}]
set_property IOSTANDARD LVCMOS33 [get_ports {sw[4]}]
set_property PACKAGE_PIN V15 [get_ports {sw[5]}]
set_property IOSTANDARD LVCMOS33 [get_ports {sw[5]}]
set_property PACKAGE_PIN W14 [get_ports {sw[6]}]
set_property IOSTANDARD LVCMOS33 [get_ports {sw[6]}]
set_property PACKAGE_PIN W13 [get_ports {sw[7]}]
set_property IOSTANDARD LVCMOS33 [get_ports {sw[7]}]
set_property PACKAGE_PIN V2 [get_ports {sw[8]}]
set_property IOSTANDARD LVCMOS33 [get_ports {sw[8]}]
set_property PACKAGE_PIN T3 [get_ports {sw[9]}]
set_property IOSTANDARD LVCMOS33 [get_ports {sw[9]}]
set_property PACKAGE_PIN T2 [get_ports {sw[10]}]
set_property IOSTANDARD LVCMOS33 [get_ports {sw[10]}]
set_property PACKAGE_PIN R3 [get_ports {sw[11]}]
set_property IOSTANDARD LVCMOS33 [get_ports {sw[11]}]
set_property PACKAGE_PIN W2 [get_ports {sw[12]}]
set_property IOSTANDARD LVCMOS33 [get_ports {sw[12]}]
set_property PACKAGE_PIN U1 [get_ports {sw[13]}]
set_property IOSTANDARD LVCMOS33 [get_ports {sw[13]}]
set_property PACKAGE_PIN T1 [get_ports {sw[14]}]
set_property IOSTANDARD LVCMOS33 [get_ports {sw[14]}]
set_property PACKAGE_PIN R2 [get_ports {sw[15]}]
set_property IOSTANDARD LVCMOS33 [get_ports {sw[15]}]
