aukhalid/evpix_rv32/fpga/rtl_src/vga_640x480.sv

// vga_640x480.sv
// Standard 640x480 timing. Designed for ~25 MHz pixel clock.

module vga_640x480 (
    input  logic clk_pix,
    input  logic reset,
    output logic [9:0] x,
    output logic [9:0] y,
    output logic       active,
    output logic       hsync,
    output logic       vsync
);

    localparam int H_VISIBLE = 640;
    localparam int H_FRONT   = 16;
    localparam int H_SYNC    = 96;
    localparam int H_BACK    = 48;
    localparam int H_TOTAL   = H_VISIBLE + H_FRONT + H_SYNC + H_BACK;

    localparam int V_VISIBLE = 480;
    localparam int V_FRONT   = 10;
    localparam int V_SYNC    = 2;
    localparam int V_BACK    = 33;
    localparam int V_TOTAL   = V_VISIBLE + V_FRONT + V_SYNC + V_BACK;

    logic [9:0] h_count;
    logic [9:0] v_count;

    always_ff @(posedge clk_pix or posedge reset) begin
        if (reset) begin
            h_count <= 10'd0;
            v_count <= 10'd0;
        end else begin
            if (h_count == H_TOTAL-1) begin
                h_count <= 10'd0;
                if (v_count == V_TOTAL-1)
                    v_count <= 10'd0;
                else
                    v_count <= v_count + 10'd1;
            end else begin
                h_count <= h_count + 10'd1;
            end
        end
    end

    assign x = h_count;
    assign y = v_count;

    assign active = (h_count < H_VISIBLE) && (v_count < V_VISIBLE);

    // VGA sync pulses are active-low
    assign hsync = ~((h_count >= H_VISIBLE + H_FRONT) &&
                     (h_count <  H_VISIBLE + H_FRONT + H_SYNC));

    assign vsync = ~((v_count >= V_VISIBLE + V_FRONT) &&
                     (v_count <  V_VISIBLE + V_FRONT + V_SYNC));

endmodule
