aukhalid/evpix_rv32/(commit log)

2026-06-23 Fix image file names in README.md
    Updated image file names in the README for TinyML, Basys-3 Board, FPGA Power Consumption, and BIST Mode sections.
2026-07-01 Add testbenches and memory files for RV32I and IPU simulations
    - Created tb_ipu_system.sv for testing the IPU system with grayscale, threshold, sobel, convolution, maxpool, and avgpool checks.
    - Added tb_rv32i_ipu_custom.sv for custom RV32I and IPU simulation with output dumping functionality.
    - Introduced tb_rv32i_top.sv for baseline regression testing of the RV32I core with register and memory checks.
    - Implemented writeback_stage.sv to handle result selection in the writeback stage of the pipeline.
    - Added memory files: memfile.hex, memfile_ipu_system.hex, memfile_pix.hex, and memfile_rv32i.hex for instruction and data loading.
